chanothy/STM-Light-Sensor/README.md

# ES-SPRING-2024
Embedded Systems Coursework Repository.
