chanothy/STM-Light-Sensor/Lab8/OSH Park Screenshot.png

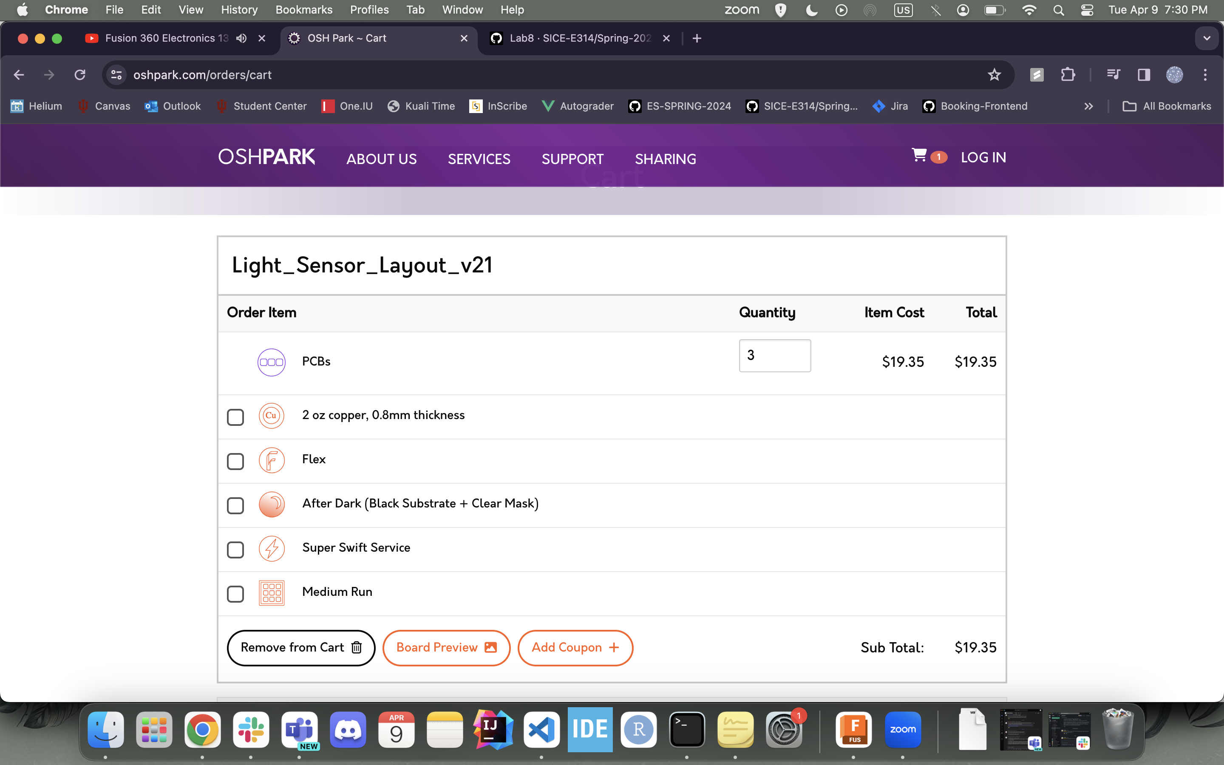
Lab8/OSH Park Screenshot.png
