chanothy/STM-Light-Sensor/Lab9/Screenshot 2024-04-19 at 11.24.21 AM.png

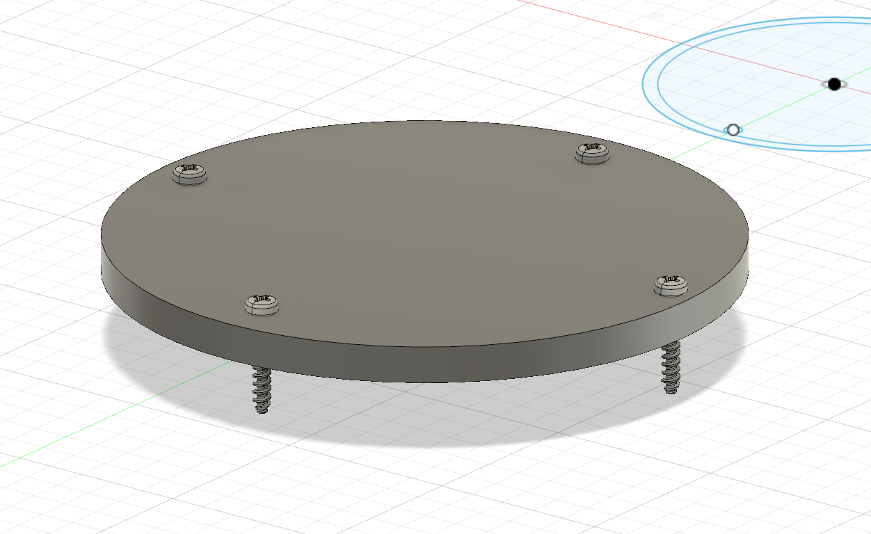
Lab9/Screenshot 2024-04-19 at 11.24.21 AM.png
