chanothy/STM-Light-Sensor/Lab7/Light Sensor BOM.pdf

Qty | Value | Device | Package | Reference Designator
1 | | PINHD-1X3 | 1X03 | JP1
3 | 0.1uF | C-USC0603 | C0603 | C1, C2, C4
1 | 1uF | C-USC0603 | C0603 | C3
2 | 200 | R-US_R0603 | R0603 | R1, R2
1 | B3B-XH-A | B3B-XH-A | B3B-XH-A | J3
1 | B4B-XH-A | B4B-XH-A | B4B-XH-A | J2
1 | BK-912-TR | BK-912-TR | MPD_BK-912-TR | BT1
1 | FTSH-107-01-L-DV-A-TR | FTSH-107-01-L-DV-A-TR | SAMTEC_FTSH-107-01-L-DV-A-TR | J4
1 | STM32L432KX | STM32L432KX | UFQFPN32-5X5MM | U1
1 | TG-3541CE_32.7680KXB3TG-3541CE_32.7680KXB3_EPS-M | TG-3541CE_32.7680KXB3TG-3541CE_32.7680KXB3_EPS-M | TG-3541CE_32.7680KXB3_EPS-M | XTAL1
2 | TPTP20SQ | TPTP20SQ | TP20SQ | TP1, TP2
1 | TSL237 | TSL237 | TSL237 | U$1

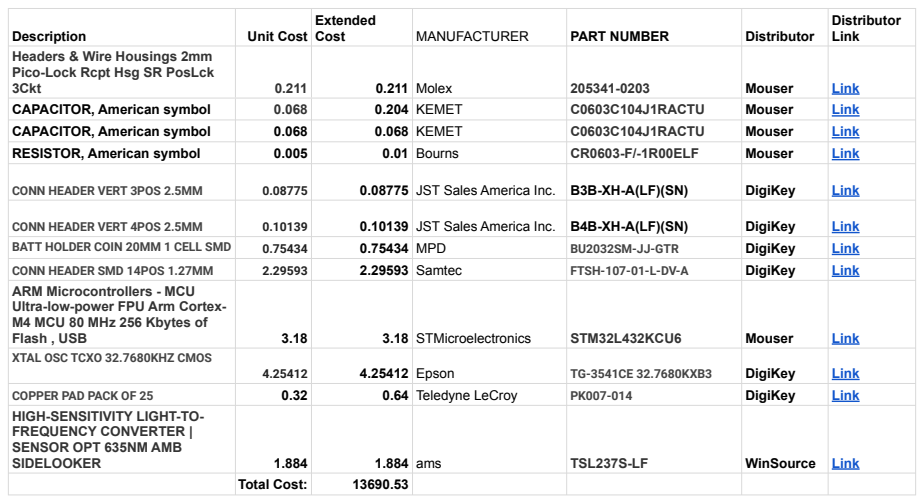
[picture p7: page 2]
Description; Unit Cost; Extended; Cost; MANUFACTURER; PART NUMBER; Distributor; Distributor Link; CAPACITOR, American symbol; 0.204 KEMET; C0603C104J1RACTU; Mouser; Link; Total Cost:

Headers & Wire Housings 2mm Pico-Lock Rcpt Hsg SR PosLck 3Ckt 0.211 | 0.211 Molex | 205341-0203 | Mouser Link (https://www.mouser.com/ProductDetail/Molex/205341-0203?qs=GedFDFLaBXHzzHE%2FGhqe1Q%3D%3D)

CAPACITOR, American symbol RESISTOR, American symbol

0.068 0.068 KEMET 0.005 0.01 Bourns | C0603C104J1RACTU CR0603-F/-1R00ELF | Mouser Link (https://www.mouser.com/ProductDetail/KEMET/C0603C104J1RACTU?qs=ulEaXIWI0c8ewiFAWf6vRw%3D%3D) Mouser Link (https://www.mouser.com/ProductDetail/Bourns/CR0603-F-1R00ELF?qs=W%2FMpXkg%252BdQ7nBNmKZ%2F9sTA%3D%3D)

CONN HEADER VERT 3POS 2.5MM 0.08775 CONN HEADER VERT 4POS 2.5MM 0.10139 BATT HOLDER COIN 20MM 1 CELL SMD 0.75434 CONN HEADER SMD 14POS 1.27MM 2.29593 | 0.08775 JST Sales America Inc. B3B-XH-A(LF)(SN) DigiKey Link (https://www.digikey.com/en/products/detail/jst-sales-america-inc/B3B-XH-A/1651046) 0.10139 JST Sales America Inc. B4B-XH-A(LF)(SN) DigiKey Link (https://www.digikey.com/en/products/detail/jst-sales-america-inc/B4B-XH-A/1651047)

0.75434 MPD 2.29593 Samtec | BU2032SM-JJ-GTR FTSH-107-01-L-DV-A | DigiKey Link (https://www.digikey.com/en/products/detail/mpd-memory-protection-devices/BU2032SM-JJ-GTR/1596664) DigiKey Link (https://www.digikey.com/en/products/detail/samtec-inc/FTSH-107-01-L-DV-A/7432932)

ARM Microcontrollers - MCU Ultra-low-power FPU Arm Cortex-M4 MCU 80 MHz 256 Kbytes of Flash , USB COPPER PAD PACK OF 25 HIGH-SENSITIVITY LIGHT-TO-FREQUENCY CONVERTER | SENSOR OPT 635NM AMB SIDELOOKER | 3.18 3.18 STMicroelectronics | STM32L432KCU6 | Mouser Link (https://www.mouser.com/ProductDetail/STMicroelectronics/STM32L432KCU6?qs=dTJS0cRn7oiybcTRwI97Tw%3D%3D)

XTAL OSC TCXO 32.7680KHZ CMOS

4.25412 | 4.25412 Epson | TG-3541CE 32.7680KXB3 | DigiKey Link (https://www.digikey.com/en/products/detail/epson/TG-3541CE-32-7680KXB3/10239841?gad_source=1)

0.32 0.64 Teledyne LeCroy 1.884 1.884 ams | | PK007-014 TSL237S-LF | DigiKey Link (https://www.digikey.com/en/products/detail/teledyne-lecroy/PK007-014/4732797) WinSource Link (https://www.win-source.net/products/detail/ams/tsl237s-lf.html)

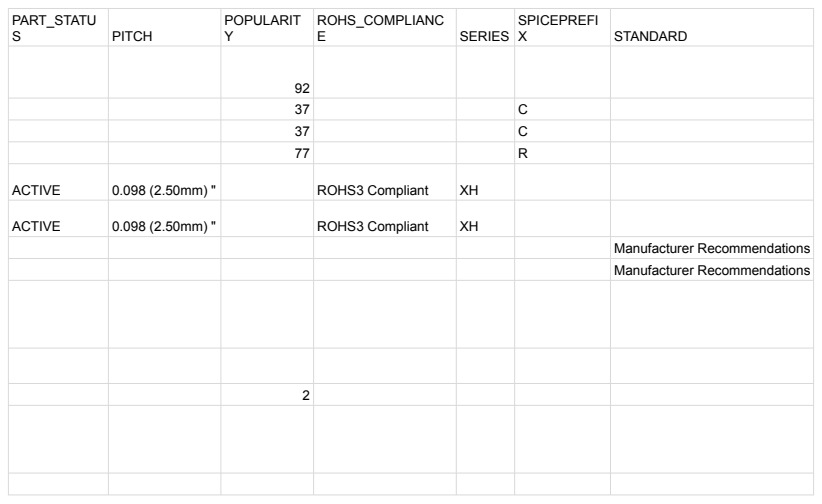
[picture p8: page 3]
PART_STATU; PITCH; POPULARIT Y; ROHS_COMPLIANC; SERIES; SPICEPREFI; STANDARD; ACTIVE; ROHS3 Compliant; Manufacturer Recommendations

SUB_CATEGORY

TP_SIGNAL_NAM
E | TYPE
Rectangular Connectors | Header, Male Pin, Board to Cable/Wire, Through Hole
Rectangular Connectors | Header, Male Pin, Board to Cable/Wire, Through Hole
