chanothy/STM-Light-Sensor/Lab7/Light Sensor Schematic.pdf

U1A

A

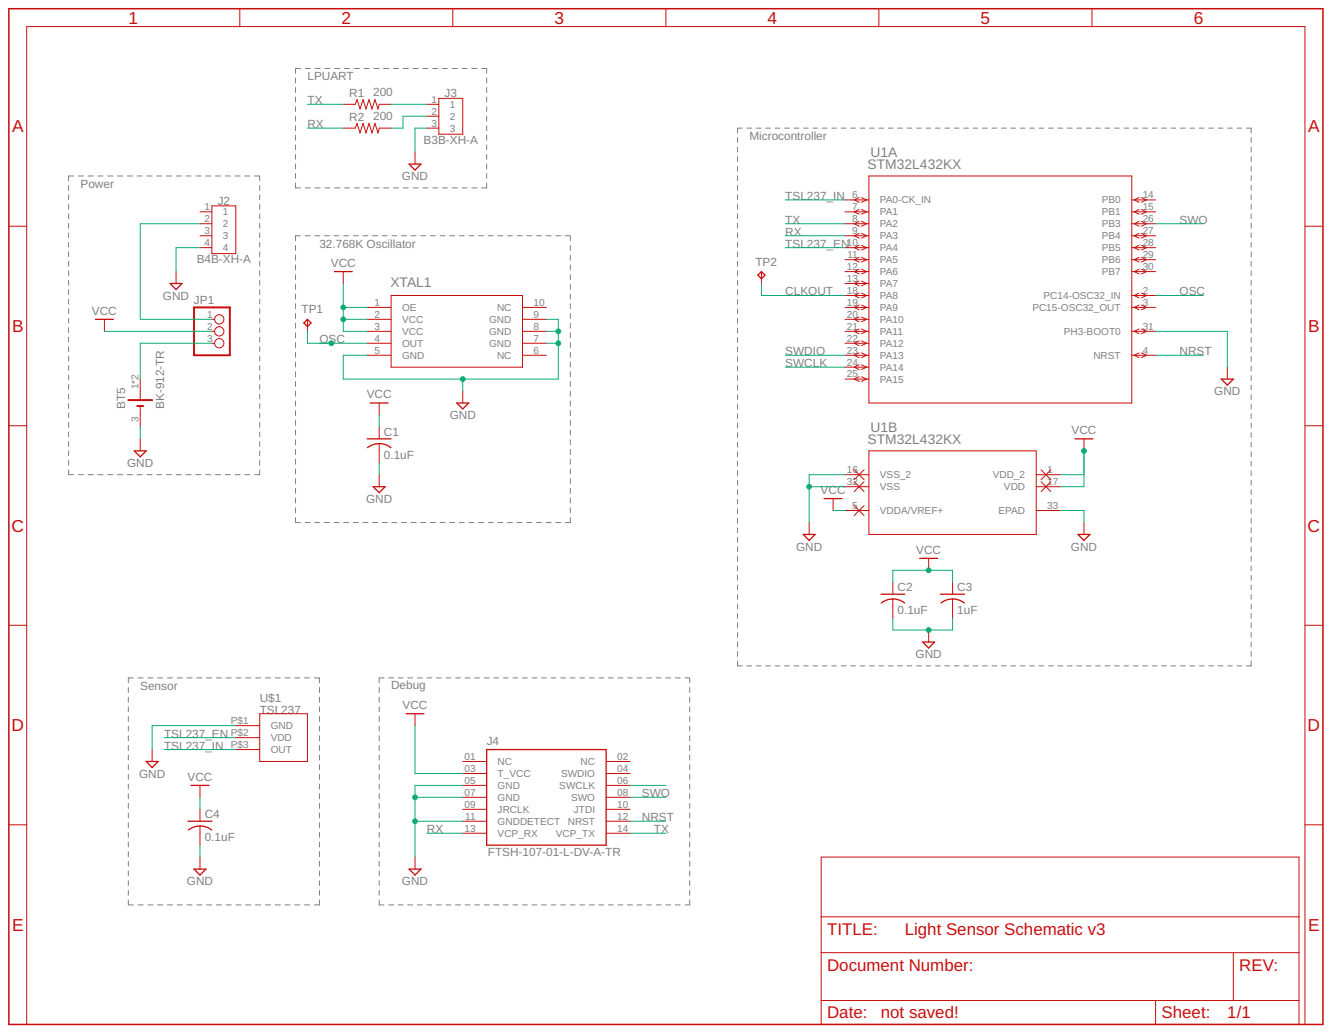
[picture p9: page 1]

Document Number: | REV:

Date: not saved! | Sheet: 1/1
