chanothy/STM-Light-Sensor/L432_project/Core/Src/main.c

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
/* Includes ------------------------------------------------------------------*/
#include "main.h"

/* USER CODE BEGIN Includes */
#include <retarget.h>
#include <stdio.h>
#include <string.h>
#include <stm32l4xx_ll_usart.h>
#include <queue.h>
#include <command.h>
#include <flash.h>
/* USER CODE END Includes */

ADC_HandleTypeDef hadc1;

RTC_HandleTypeDef hrtc;

TIM_HandleTypeDef htim2;

UART_HandleTypeDef huart2;

/* USER CODE BEGIN PV */
queue_t buf;
uint8_t command[16]; // idk how big to make this
int command_length;
int alarm = 0;
volatile uint32_t period;
volatile float tsl237_clock_period;
volatile float tsl237_clock_frequency;
sensorval_t mySensors;
flash_status_t fs;
/* USER CODE END PV */

void SystemClock_Config(void);
static void MX_GPIO_Init(void);
static void MX_USART2_UART_Init(void);
static void MX_RTC_Init(void);
static void MX_TIM2_Init(void);
static void MX_ADC1_Init(void);
/* USER CODE BEGIN 0 */
//typedef struct sensorval {
//  uint32_t vdda_value;
//  uint32_t temperature;
//} sensorval_t;
uint32_t readsensor(sensorval_t *sensors) {
	uint32_t temp_raw;
	uint32_t vrefint_raw;

	if (!sensors) {
		return (-1);
	}
	HAL_ADCEx_Calibration_Start(&hadc1, ADC_SINGLE_ENDED);
	HAL_ADC_Start(&hadc1);
	HAL_ADC_PollForConversion(&hadc1, HAL_MAX_DELAY);
	temp_raw = HAL_ADC_GetValue(&hadc1);
	HAL_ADC_PollForConversion(&hadc1, HAL_MAX_DELAY);
	vrefint_raw = HAL_ADC_GetValue(&hadc1);
	HAL_ADC_Stop(&hadc1);
	sensors->vdda_value = __HAL_ADC_CALC_VREFANALOG_VOLTAGE(vrefint_raw,
			ADC_RESOLUTION_12B);
	sensors->temperature = __HAL_ADC_CALC_TEMPERATURE(sensors->vdda_value,
			temp_raw, ADC_RESOLUTION_12B);

	return (0);
}

void HAL_TIM_IC_CaptureCallback(TIM_HandleTypeDef *htim) {
	static uint32_t last = 0;
	uint32_t current;
	if (htim->Channel == HAL_TIM_ACTIVE_CHANNEL_1) {
		current = htim->Instance->CCR1;
		if (last <= current) {
			period = current - last;
		} else {
			period = TIM2->ARR - last + current;
		}
		last = current;
	}
}
/* USER CODE END 0 */

/**
  * @brief  The application entry point.
  * @retval int
  */
int main(void)
{
  /* USER CODE BEGIN 1 */
	init_queue(&buf);
	uint32_t captures[2];
  /* USER CODE END 1 */

  /* MCU Configuration--------------------------------------------------------*/

  /* Reset of all peripherals, Initializes the Flash interface and the Systick. */
  HAL_Init();

  /* Configure the system clock */
  SystemClock_Config();

  /* Initialize all configured peripherals */
  MX_GPIO_Init();
  MX_USART2_UART_Init();
  MX_RTC_Init();
  MX_TIM2_Init();
  MX_ADC1_Init();
  /* USER CODE BEGIN 2 */
	RetargetInit(&huart2);
	LL_USART_EnableIT_RXNE(USART2);    // Turn on the usart2 interrupt
	HAL_TIM_IC_Start_DMA(&htim2, TIM_CHANNEL_1, (uint32_t*) captures, 2);


  /* USER CODE END 2 */

  /* Infinite loop */
  /* USER CODE BEGIN WHILE */
	flash_erase();
	printf("System Up and Running\n\r");

  flash_write_init(&fs);
//  printf("Flash Total Records: %d\n\r",fs.total_records);
//	printf("Data: %d\n\r", (((sensordata_t*)(0x0803FFF0))->record_number));
	store_log_data(&fs, "start");

//	if (arguments) {
//				char *pt;
//				pt = strtok (arguments,",");
//				store_log_data(&fs, pt);
//			}
//		else {
//			store_log_data(&fs, "start");
//		}

	prompt();
	while (1) {
		HAL_Delay(100);
		readsensor(&mySensors);
		tsl237_clock_period = (1 / (float) SystemCoreClock) * (float) period;
		tsl237_clock_frequency = 1 / tsl237_clock_period;

		if (get_commands(command)) {
			command_length = 16;
			if (command_length != -1) {
				if (execute_command(command)) {
					printf("NOK\n\r");
					prompt();
				} else {
					printf("OK\n\r");
					prompt();
				}
			} else {
				printf("NOK\n\r");
				prompt();
			}
		}

		if (alarm) {
			printf("alarm_triggered\n\r");
			lon_command();
			HAL_Delay(100);
			lof_command();
			alarm = 0;
		}
    /* USER CODE END WHILE */

    /* USER CODE BEGIN 3 */

	}
  /* USER CODE END 3 */
}

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
