chanothy/STM-Light-Sensor/L432_project/L432_project.ioc

Mcu.UserName=STM32L432KCUx
PA0.GPIO_Label=MCO [High speed clock in]
PA0.Signal=RCC_CK_IN
PA2.GPIO_Label=VCP_TX
PA2.Signal=USART2_TX
PA5.Signal=S_TIM2_CH1
