chanothy/STM-Light-Sensor/(commit log)

2024-01-17 include printf, build
2024-01-17 printing update in while
2024-01-19 milestone-2 led_on/led-off
2024-01-26 Configuring interrupt
2024-01-30 Added provided interrupt and queue files
2024-02-02 commands working with rework
    [main.c]
2024-02-02 interrupt timer
2024-02-08 set/get date/time, updated command prompt to display current datetime
2024-02-08 Fix lon/lof function calls
    [command.c, main.c]
2024-02-20 timer returns period
2024-02-23 light sensor
2024-02-26 light sensor working
2024-02-28 battery and adc
2024-03-25 update log and sample
2024-04-05 part 1 and 2
    [BOM.xlsx]
2024-04-26 Prototype Cost Analysis
2024-04-26 Update power consumption
