chanothy/STM-Light-Sensor/(notices)

Notices in the files:
L432_project/Core/Inc/main.h:
Copyright (c) 2024 STMicroelectronics.
All rights reserved.
This software is licensed under terms that can be found in the LICENSE file
L432_project/Core/Inc/queue.h:
modify it under the terms of the GNU General Public License as
published by the Free Software Foundation; either version 3, or
(at your option) any later version.
